mesgas/opentherm-smartthings-gateway/hardware/production/bom-lcsc.csv

Quantity | LCSC Part Number | Description | Package | Designator
2 | C1713 | 10u/16V | C_0805_2012Metric | C1,C5
1 | C1804 | 22p | C_0805_2012Metric | C2
3 | C49678 | 100n/50V / 100n | C_0805_2012Metric | C3,C6,C7
1 | C440198 | 10u/50V | C_0805_2012Metric | C4
2 | C28323 | 1u | C_0805_2012Metric | C8,C9
3 | C8598 | 1N5819W | D_SOD-123 | D1,D13,D14
4 | C7420318 | 1N4148W | D_SOD-123 | D2,D3,D4,D5
1 | C19077400 | 4V7 | D_SOD-123 | D6
1 | C22399883 | 13V | D_SOD-123 | D7
1 | C19077399 | 4V3 | D_SOD-123 | D8
1 | C22399882 | 8V2 | D_SOD-123 | D9
2 | C84256 | PWR / USER | LED_0805_2012Metric | D10,D15
1 | C2297 | RxB | LED_0805_2012Metric | D11
1 | C2296 | RxT | LED_0805_2012Metric | D12
2 | C113964 | SMAJ28CA | D_SMA | D16,D17
4 | C474892 | BOILER / THERM / 5V IN / NTC | TerminalBlock_4Ucon_1x02_P3.50mm_Horizontal | J1,J2,J5,J6
1 | C165948 | USB-C | USB_C_Receptacle_HRO_TYPE-C-31-M-12 | J3
1 | C177242 | 10uH | L_Bourns-SRN4018 | L1
4 | C7420352 | MMBT2907A | SOT-23 | Q1,Q2,Q3,Q4
2 | C8512 | MMBT2222A | SOT-23 | Q5,Q6
1 | C25824 | 240k | R_0805_2012Metric | R1
1 | C17455 | 13k | R_0805_2012Metric | R2
2 | C17630 | 330 | R_0805_2012Metric | R3,R17
1 | C17557 | 220 | R_0805_2012Metric | R4
2 | C17408 | 100 | R_0805_2012Metric | R5,R8
1 | C28636 | 560 | R_0805_2012Metric | R6
6 | C17414 | 10k | R_0805_2012Metric | R7,R12,R22,R23,R24,R25
1 | C17633 | 33k | R_0805_2012Metric | R9
2 | C17544 | 20 | R_0805_2012Metric | R10,R11
1 | C17470 | 150k | R_0805_2012Metric | R13
3 | C17513 | 1k | R_0805_2012Metric | R14,R18,R26
1 | C17673 | 4k7 | R_0805_2012Metric | R15
1 | C17798 | 680 | R_0805_2012Metric | R16
2 | C27834 | 5k1 | R_0805_2012Metric | R19,R20
1 | C110775 | 10k 0.1% | R_0805_2012Metric | R21
2 | C72443 | RESET / BOOT | SW_Push_1P1T_NO_CK_KMR2 | SW1,SW2
1 | C181783 | MT3540-F23 | SOT-23-5 | U1
2 | C109227 | LTV-817S | SMDIP-4_W9.53mm | U2,U3
1 | C2934560 | ESP32-C3-WROOM-02-N4 | ESP32-C3-WROOM-02 | U4
1 | C51118 | AP2112K-3.3 | SOT-23-5 | U5
1 | C7519 | USBLC6-2SC6 | SOT-23-6 | U6
