mesgas/opentherm-smartthings-gateway/hardware/opentherm-gateway.kicad_pcb

## KiCad design hardware/opentherm-gateway.kicad_pcb (2026-10-15)

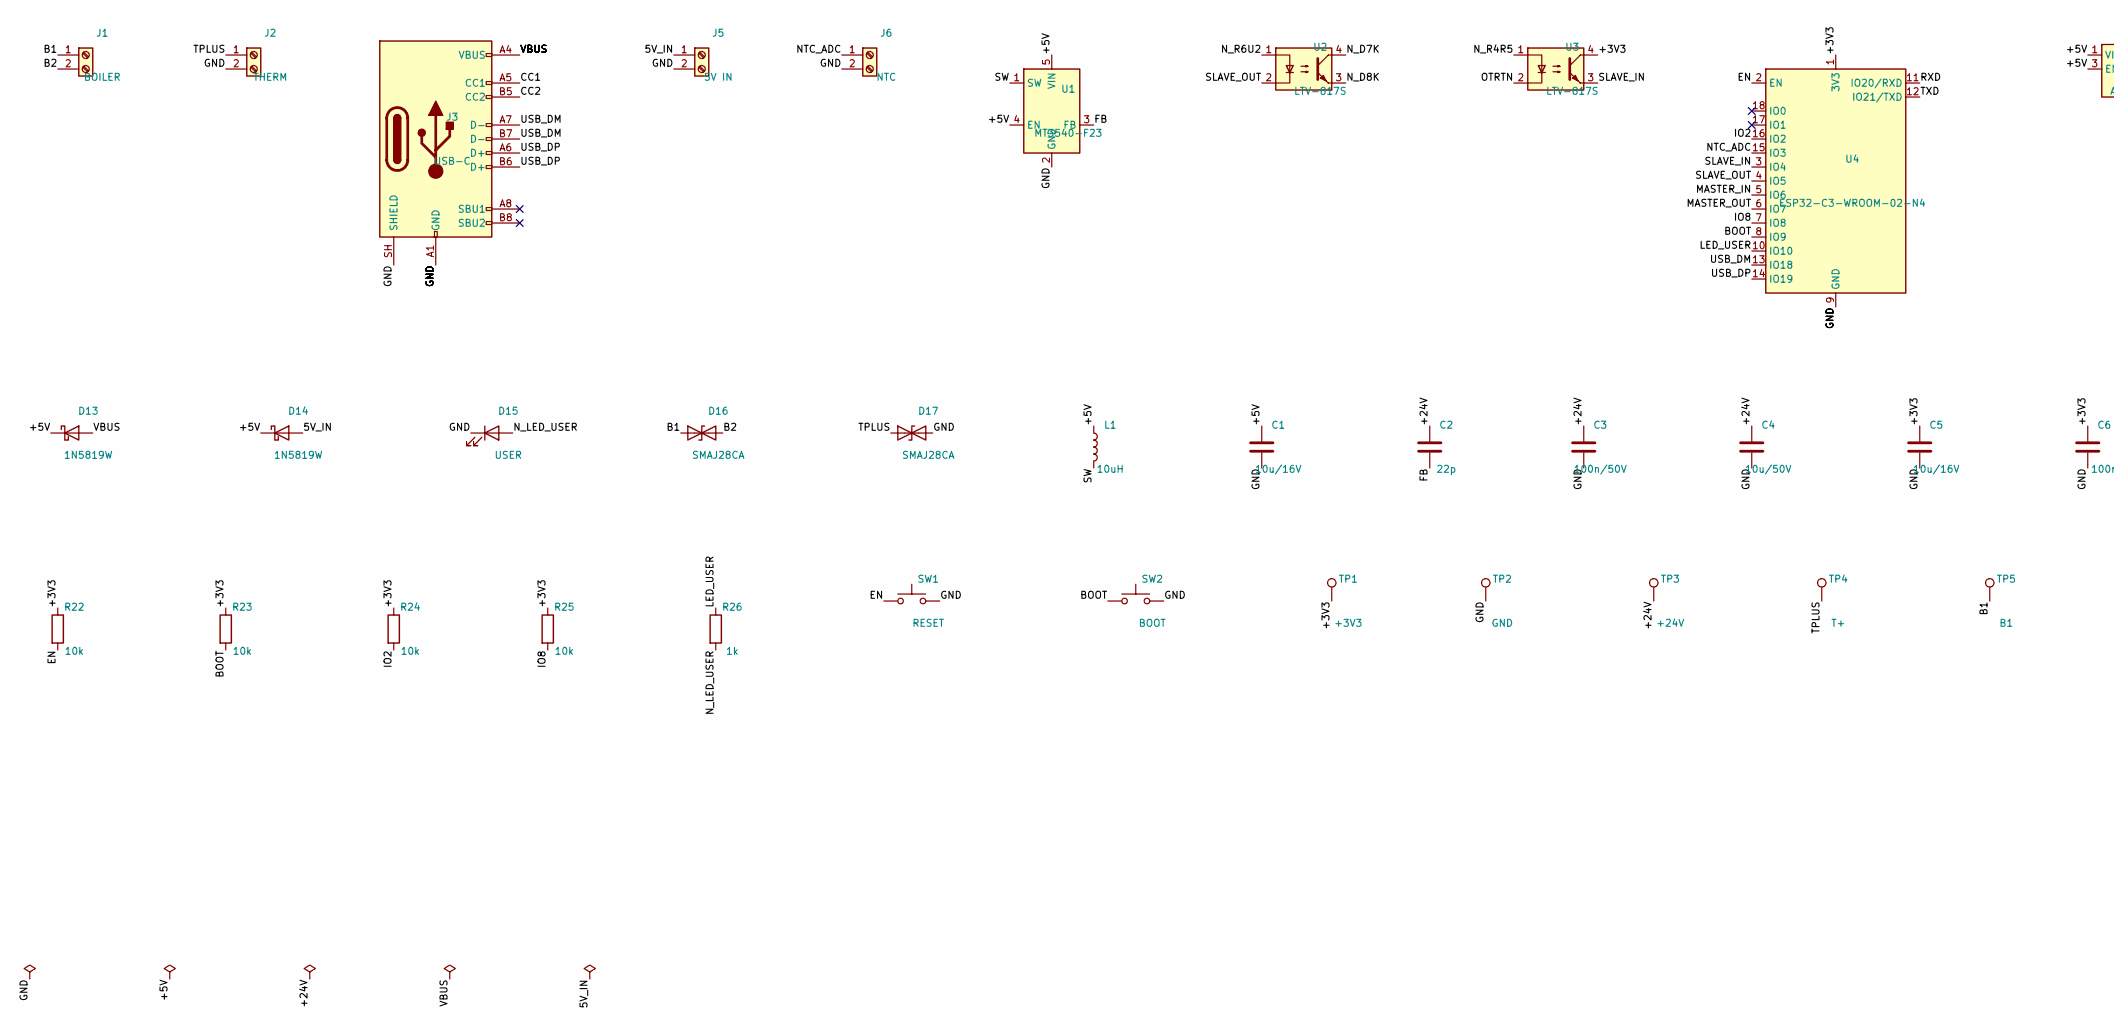
[picture p1: schematic opentherm-gateway.kicad_sch, OpenTherm gateway, part in row 1, column 1]

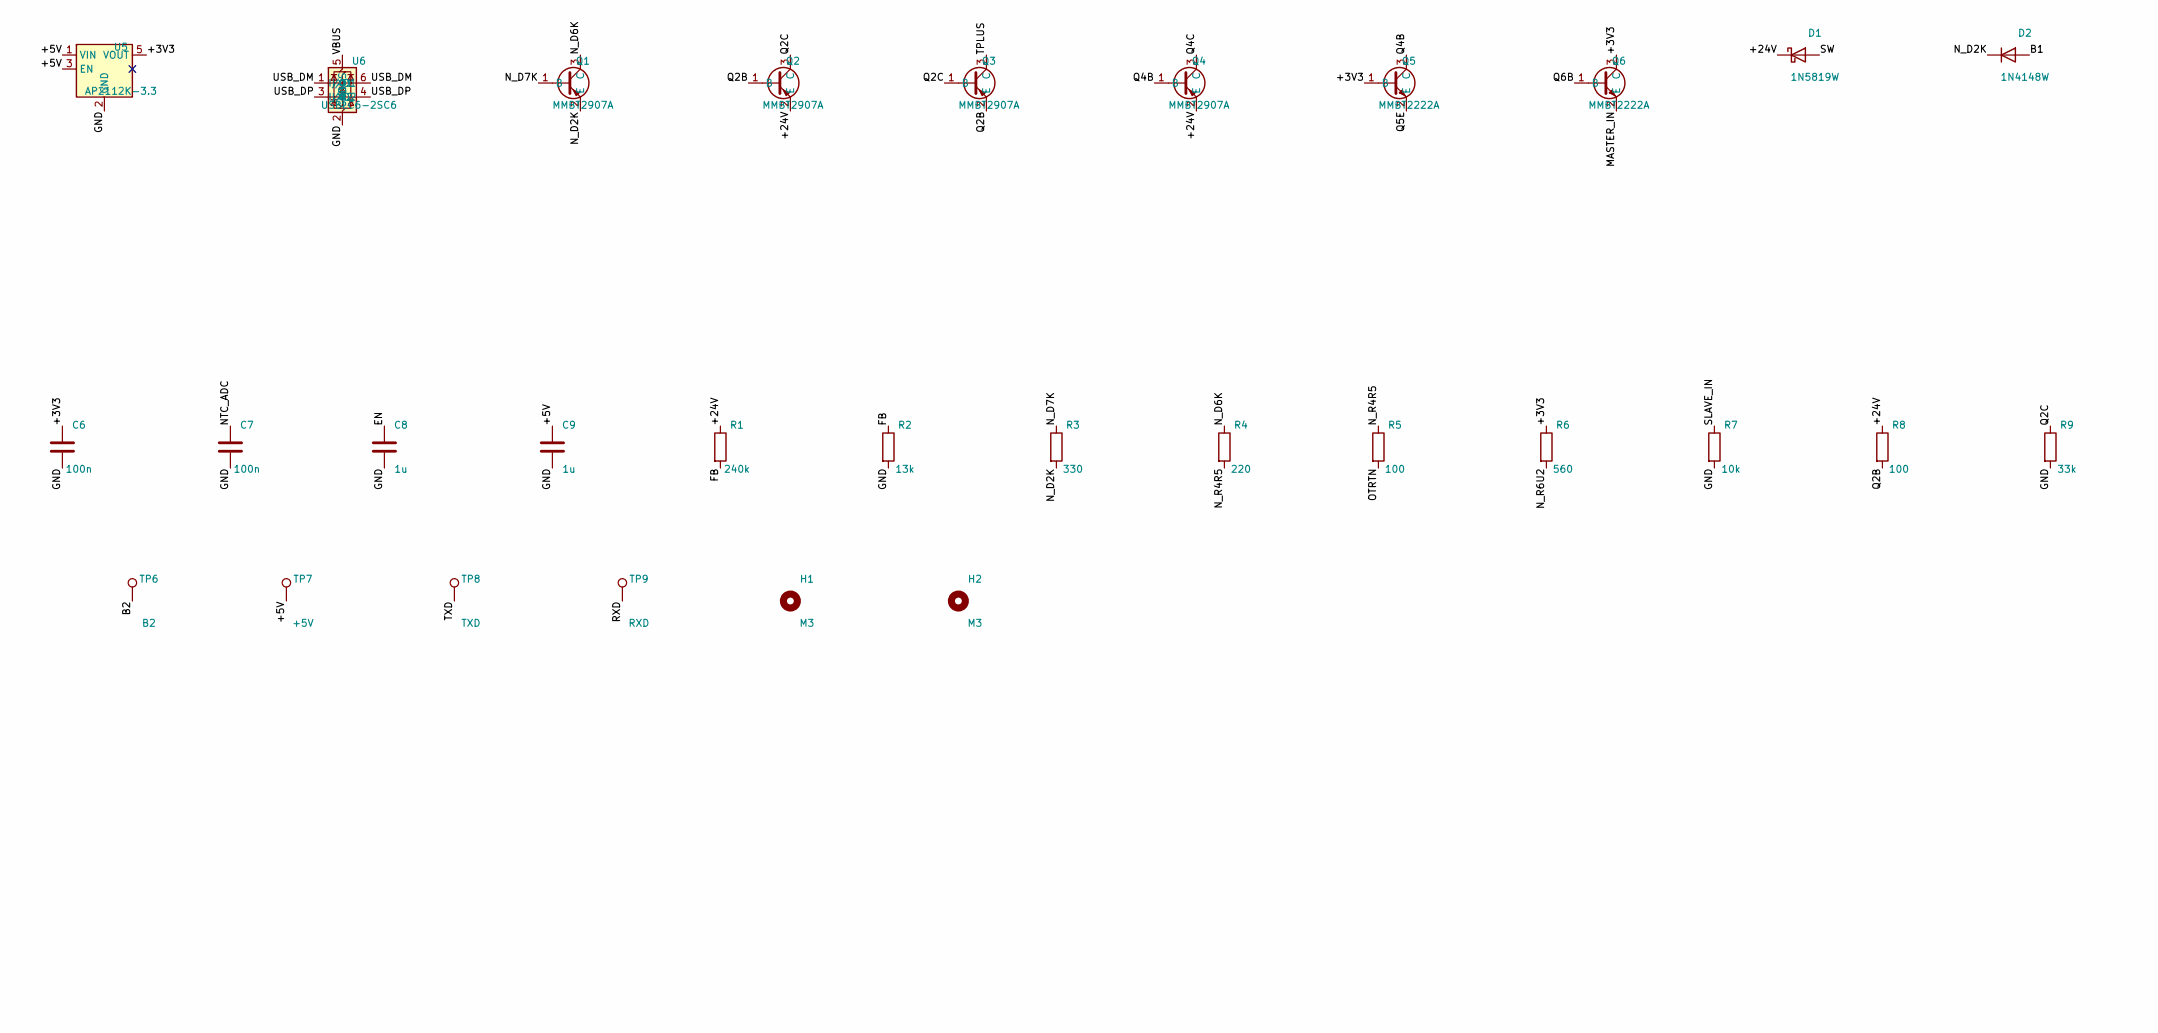
[picture p2: schematic opentherm-gateway.kicad_sch, OpenTherm gateway, part in row 1, column 2]

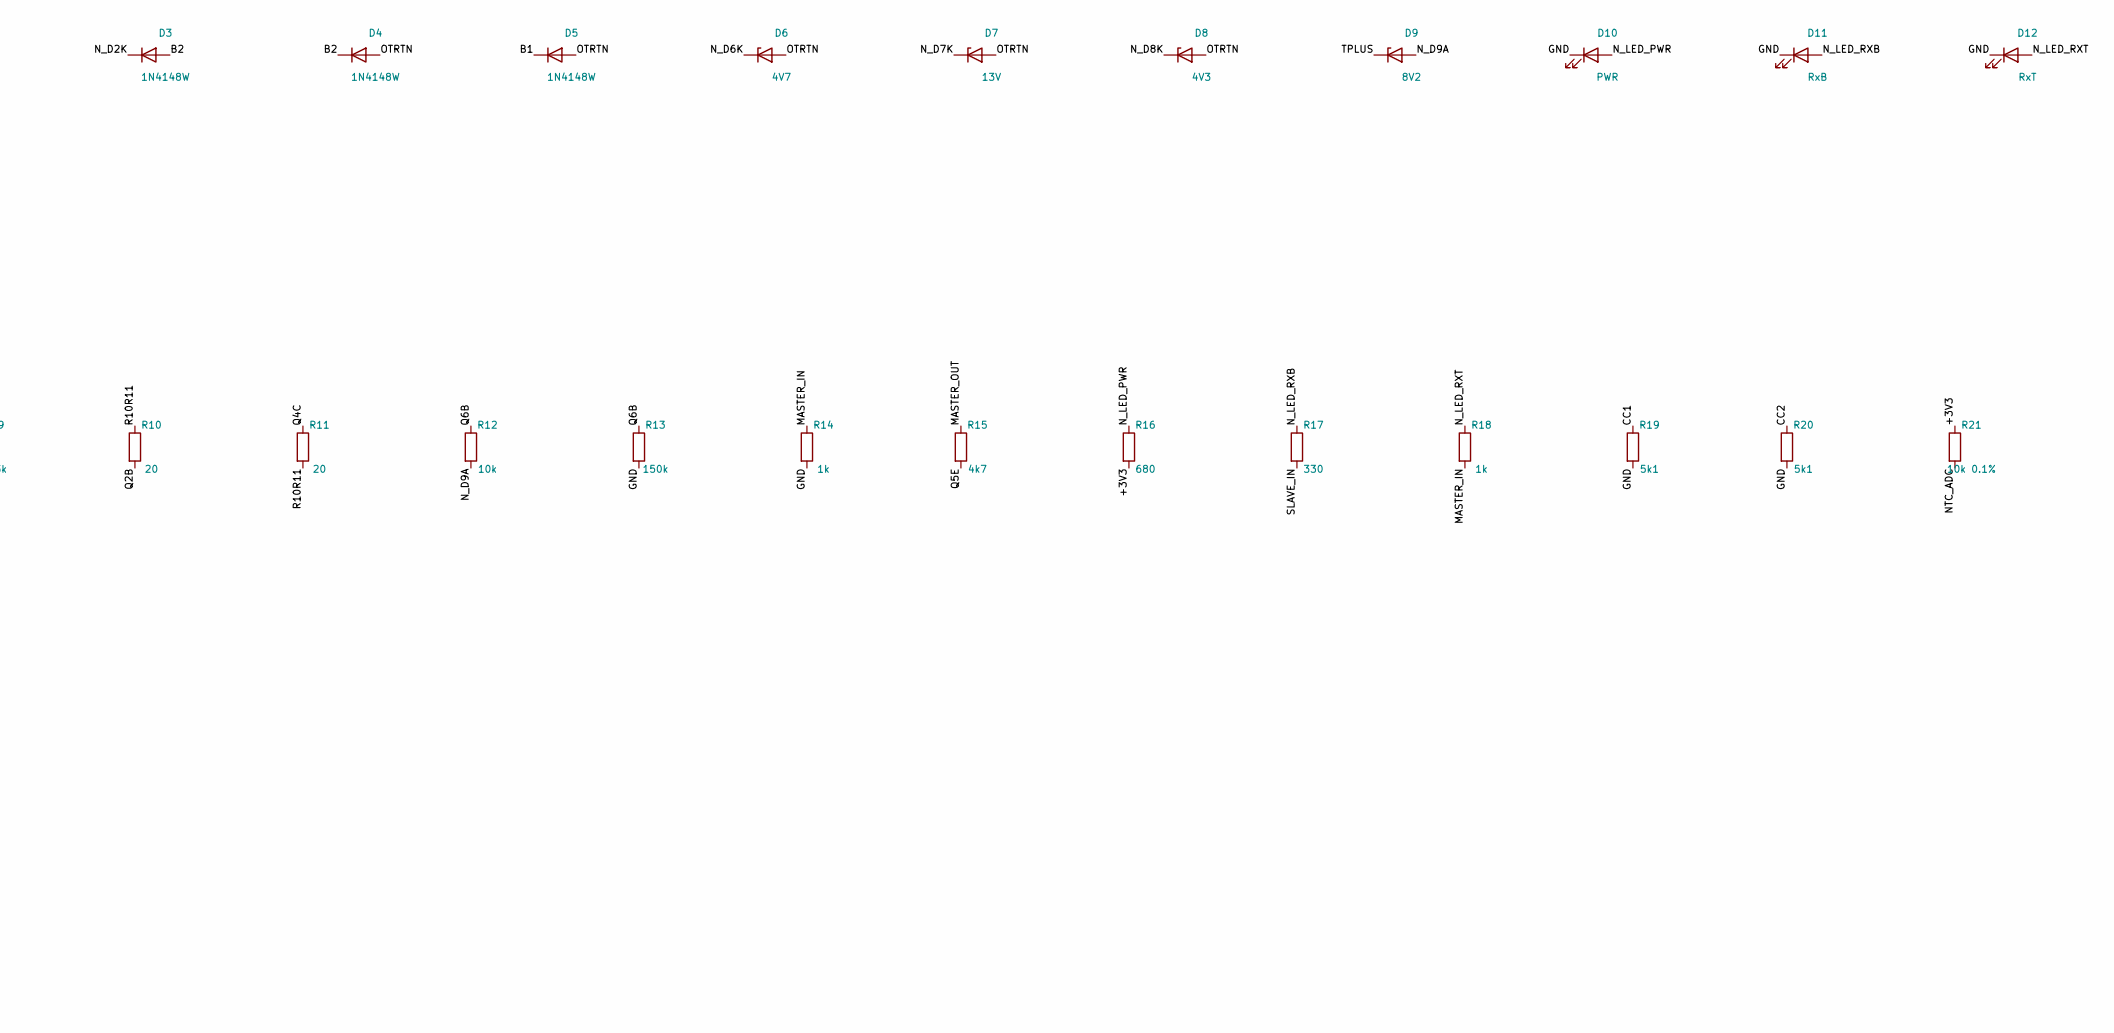
[picture p3: schematic opentherm-gateway.kicad_sch, OpenTherm gateway, part in row 1, column 3]

Parts:
C1, C5: 10u/16V; C_0805_2012Metric; LCSC C1713
C2: 22p; C_0805_2012Metric; LCSC C1804
C3: 100n/50V; C_0805_2012Metric; LCSC C49678
C4: 10u/50V; C_0805_2012Metric; LCSC C440198
C6, C7: 100n; C_0805_2012Metric; LCSC C49678
C8, C9: 1u; C_0805_2012Metric; LCSC C28323
D1, D13, D14: 1N5819W; D_SOD-123; LCSC C8598
D2, D3, D4, D5: 1N4148W; D_SOD-123; LCSC C7420318
D6: 4V7; D_SOD-123; LCSC C19077400
D7: 13V; D_SOD-123; LCSC C22399883
D8: 4V3; D_SOD-123; LCSC C19077399
D9: 8V2; D_SOD-123; LCSC C22399882
D10: PWR; LED_0805_2012Metric; LCSC C84256
D11: RxB; LED_0805_2012Metric; LCSC C2297
D12: RxT; LED_0805_2012Metric; LCSC C2296
D15: USER; LED_0805_2012Metric; LCSC C84256
D16, D17: SMAJ28CA; D_SMA; LCSC C113964
H1, H2: M3; MountingHole_3.2mm_M3
J1: BOILER; TerminalBlock_4Ucon_1x02_P3.50mm_Horizontal; LCSC C474892
J2: THERM; TerminalBlock_4Ucon_1x02_P3.50mm_Horizontal; LCSC C474892
J3: USB-C; USB_C_Receptacle_HRO_TYPE-C-31-M-12; LCSC C165948
J5: 5V IN; TerminalBlock_4Ucon_1x02_P3.50mm_Horizontal; LCSC C474892
J6: NTC; TerminalBlock_4Ucon_1x02_P3.50mm_Horizontal; LCSC C474892
L1: 10uH; L_Bourns-SRN4018; LCSC C177242
Q1, Q2, Q3, Q4: MMBT2907A; SOT-23; LCSC C7420352
Q5, Q6: MMBT2222A; SOT-23; LCSC C8512
R1: 240k; R_0805_2012Metric; LCSC C25824
R2: 13k; R_0805_2012Metric; LCSC C17455
R3, R17: 330; R_0805_2012Metric; LCSC C17630
R4: 220; R_0805_2012Metric; LCSC C17557
R5, R8: 100; R_0805_2012Metric; LCSC C17408
R6: 560; R_0805_2012Metric; LCSC C28636
R7, R12, R22, R23, R24, R25: 10k; R_0805_2012Metric; LCSC C17414
R9: 33k; R_0805_2012Metric; LCSC C17633
R10, R11: 20; R_0805_2012Metric; LCSC C17544
R13: 150k; R_0805_2012Metric; LCSC C17470
R14, R18, R26: 1k; R_0805_2012Metric; LCSC C17513
R15: 4k7; R_0805_2012Metric; LCSC C17673
R16: 680; R_0805_2012Metric; LCSC C17798
R19, R20: 5k1; R_0805_2012Metric; LCSC C27834
R21: 10k 0.1%; R_0805_2012Metric; LCSC C110775
SW1: RESET; SW_Push_1P1T_NO_CK_KMR2; LCSC C72443
SW2: BOOT; SW_Push_1P1T_NO_CK_KMR2; LCSC C72443
TP1: +3V3; TestPoint_Pad_D1.5mm
TP2: GND; TestPoint_Pad_D1.5mm
TP3: +24V; TestPoint_Pad_D1.5mm
TP4: T+; TestPoint_Pad_D1.5mm
TP5: B1; TestPoint_Pad_D1.5mm
TP6: B2; TestPoint_Pad_D1.5mm
TP7: +5V; TestPoint_Pad_D1.5mm
TP8: TXD; TestPoint_Pad_D1.5mm
TP9: RXD; TestPoint_Pad_D1.5mm
U1: MT3540-F23; SOT-23-5; LCSC C181783
U2, U3: LTV-817S; SMDIP-4_W9.53mm; LCSC C109227
U4: ESP32-C3-WROOM-02-N4; ESP32-C3-WROOM-02; LCSC C2934560
U5: AP2112K-3.3; SOT-23-5; LCSC C51118
U6: USBLC6-2SC6; SOT-23-6; LCSC C7519

Connections:
5V_IN: D14.2 (A), J5.1
+3V3: C5.1, C6.1, Q5.1 (B), Q6.3 (C), R6.1, R16.2, R21.1, R22.1, R23.1, R24.1, R25.1, TP1.1, U3.4, U4.1 (3V3), U5.5 (VOUT)
+5V: C1.1, C9.1, D13.1 (K), D14.1 (K), L1.1, TP7.1, U1.4 (EN), U1.5 (VIN), U5.1 (VIN), U5.3 (EN)
+24V: C2.1, C3.1, C4.1, D1.1 (K), Q2.2 (E), Q4.2 (E), R1.1, R8.1, TP3.1
B1: D2.2 (A), D5.1 (K), D16.1 (A1), J1.1, TP5.1
B2: D3.2 (A), D4.1 (K), D16.2 (A2), J1.2, TP6.1
BOOT: R23.2, SW2.1, U4.8 (IO9)
CC1: J3.A5 (CC1), R19.1
CC2: J3.B5 (CC2), R20.1
EN: C8.1, R22.2, SW1.1, U4.2 (EN)
FB: C2.2, R1.2, R2.1, U1.3 (FB)
GND: C1.2, C3.2, C4.2, C5.2, C6.2, C7.2, C8.2, C9.2, D10.1 (K), D11.1 (K), D12.1 (K), D15.1 (K), D17.2 (A2), J2.2, J3.A1 (GND), J3.A12 (GND), J3.B1 (GND), J3.B12 (GND), J3.SH (SHIELD), J5.2, J6.2, R2.2, R7.2, R9.2, R13.2, R14.2, R19.2, R20.2, SW1.2, SW2.2, TP2.1, U1.2 (GND), U4.9 (GND), U4.19 (GND), U5.2 (GND), U6.2 (GND)
IO2: R24.2, U4.16 (IO2)
IO8: R25.2, U4.7 (IO8)
LED_USER: R26.1, U4.10 (IO10)
MASTER_IN: Q6.2 (E), R14.1, R18.2, U4.5 (IO6)
MASTER_OUT: R15.1, U4.6 (IO7)
NTC_ADC: C7.1, J6.1, R21.2, U4.15 (IO3)
N_D2K: D2.1 (K), D3.1 (K), Q1.2 (E), R3.2
N_D6K: D6.1 (K), Q1.3 (C), R4.1
N_D7K: D7.1 (K), Q1.1 (B), R3.1, U2.4
N_D8K: D8.1 (K), U2.3
N_D9A: D9.2 (A), R12.2
N_LED_PWR: D10.2 (A), R16.1
N_LED_RXB: D11.2 (A), R17.1
N_LED_RXT: D12.2 (A), R18.1
N_LED_USER: D15.2 (A), R26.2
N_R4R5: R4.2, R5.1, U3.1
N_R6U2: R6.2, U2.1
OTRTN: D4.2 (A), D5.2 (A), D6.2 (A), D7.2 (A), D8.2 (A), R5.2, U3.2
Q2B: Q2.1 (B), Q3.2 (E), R8.2, R10.2
Q2C: Q2.3 (C), Q3.1 (B), R9.1
Q4B: Q4.1 (B), Q5.3 (C)
Q4C: Q4.3 (C), R11.1
Q5E: Q5.2 (E), R15.2
Q6B: Q6.1 (B), R12.1, R13.1
R10R11: R10.1, R11.2
RXD: TP9.1, U4.11 (IO20/RXD)
SLAVE_IN: R7.1, R17.2, U3.3, U4.3 (IO4)
SLAVE_OUT: U2.2, U4.4 (IO5)
SW: D1.2 (A), L1.2, U1.1 (SW)
TPLUS: D9.1 (K), D17.1 (A1), J2.1, Q3.3 (C), TP4.1
TXD: TP8.1, U4.12 (IO21/TXD)
USB_DM: J3.A7 (D-), J3.B7 (D-), U4.13 (IO18), U6.1 (I/O1), U6.6 (I/O1)
USB_DP: J3.A6 (D+), J3.B6 (D+), U4.14 (IO19), U6.3 (I/O2), U6.4 (I/O2)
VBUS: D13.2 (A), J3.A4 (VBUS), J3.A9 (VBUS), J3.B4 (VBUS), J3.B9 (VBUS), U6.5 (VBUS)

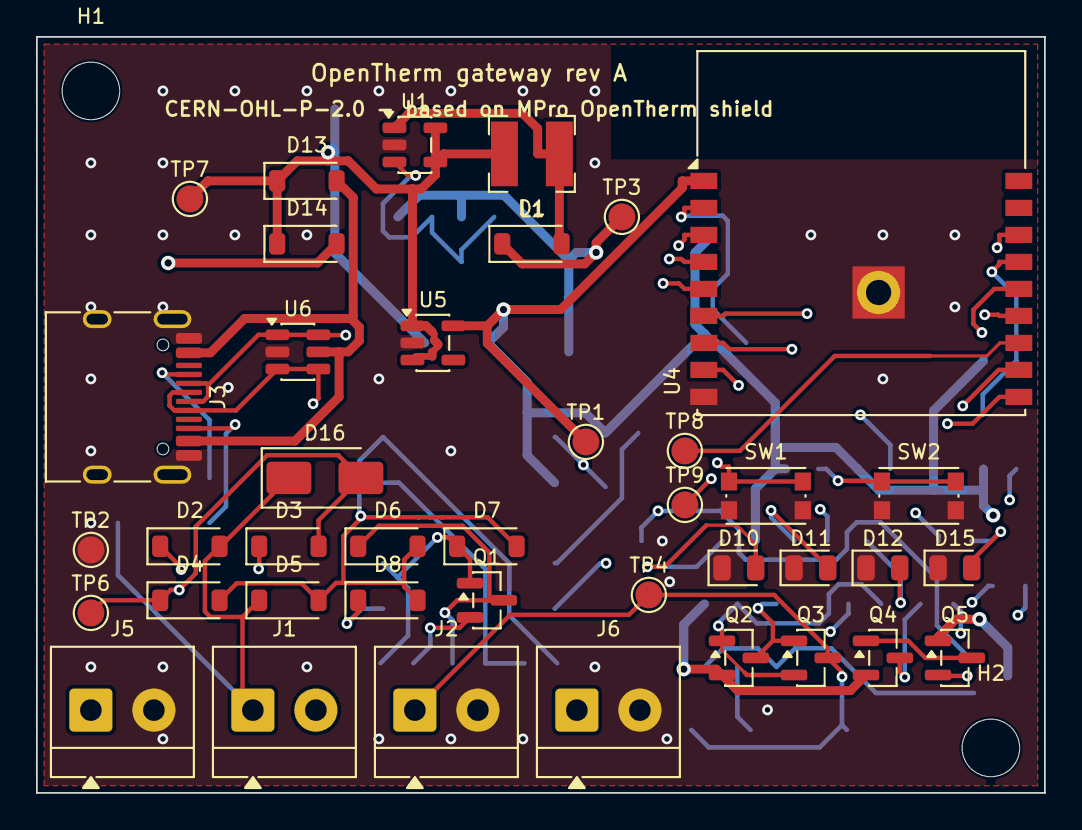
[picture p4: board opentherm-gateway.kicad_pcb from above]

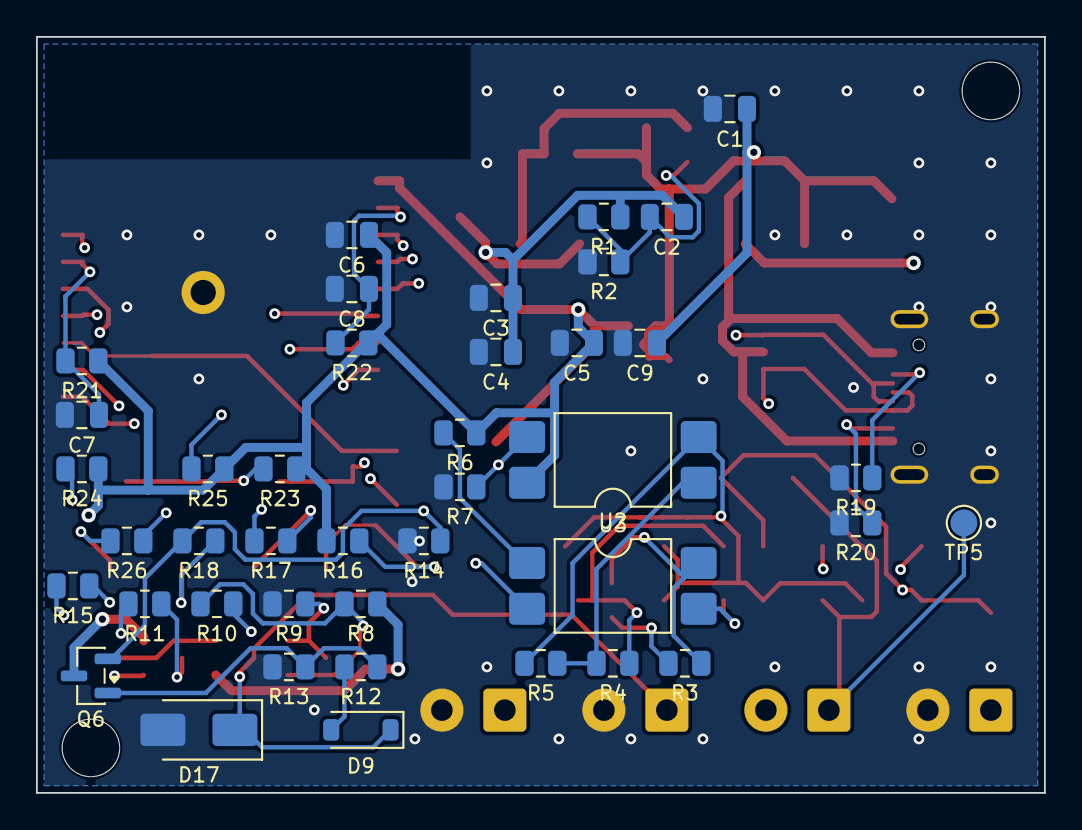
[picture p5: board opentherm-gateway.kicad_pcb from below]

Board: 4 copper layers, 56.0 x 42.0 mm, 83 parts (41 on the bottom side), 46 nets.
