mesgas/opentherm-smartthings-gateway/hardware/gen/placement.py

"""Placement table: ref -> (x, y, rotation_deg, side). Board origin top-left, mm.

Compact 4-layer board, parts on both sides:
  top    USB-C (left edge), ESP32-C3-WROOM-02 (antenna to the top edge), 4 screw terminals along
         the bottom edge, buttons, LEDs, boost converter, boiler-side bridge/zeners
  bottom optocouplers (isolation barrier), thermostat-side transistors, small passives
"""
BOARD_W = 56.0
BOARD_H = 42.0

PLACE = {
    # --- connectors / mechanical ---------------------------------------------------
    "J3": (4.4, 20.0, 270, "F"),
    "U4": (45.8, 14.0, 0, "F"),
    "J5": (3.0, 37.4, 0, "F"),
    "J1": (12.0, 37.4, 0, "F"),
    "J2": (21.0, 37.4, 0, "F"),
    "J6": (30.0, 37.4, 0, "F"),
    "H1": (3.0, 3.0, 0, "F"),
    "H2": (53, 39.5, 0, "F"),
    "H3": (53.0, 3.0, 0, "B"),     # placeholder, removed below
    "H4": (3.0, 39.0, 0, "B"),
    # --- USB / supply ---------------------------------------------------------------
    "U6": (14.5, 17.5, 0, "F"),
    "D13": (15.0, 8.0, 0, "F"),
    "D14": (15.0, 11.5, 0, "F"),
    "R19": (10.5, 24.5, 0, "B"),
    "R20": (10.5, 27.0, 0, "B"),
    "U5": (22.0, 17.0, 0, "F"),
    "C5": (26, 17, 0, "B"),
    "C9": (22.5, 17, 0, "B"),
    # --- boost converter ------------------------------------------------------------
    "U1": (21.0, 6.0, 0, "F"),
    "L1": (27.5, 6.5, 0, "F"),
    "D1": (27.5, 11.5, 0, "F"),
    "C1": (17.5, 4.0, 0, "B"),
    "C2": (21.0, 10.0, 0, "B"),
    "R1": (24.5, 10.0, 0, "B"),
    "R2": (24.5, 12.5, 0, "B"),
    "C3": (30.5, 14.5, 0, "B"),
    "C4": (30.5, 17.5, 0, "B"),
    # --- MCU --------------------------------------------------------------------------
    "C6": (38.5, 11.0, 0, "B"),
    "C8": (38.5, 14.0, 0, "B"),
    "SW1": (40.5, 25.5, 0, "F"),
    "SW2": (49.0, 25.5, 0, "F"),
    "R22": (38.5, 17.0, 0, "B"),
    "R23": (42.5, 24.0, 0, "B"),
    "R25": (46.5, 24.0, 0, "B"),
    "R24": (53.5, 24.0, 0, "B"),
    "R21": (53.5, 18.0, 0, "B"),
    "C7": (53.5, 21.0, 0, "B"),
    "R26": (51.0, 28.0, 0, "B"),
    "D15": (51, 29.5, 0, "F"),
    "D10": (39, 29.5, 0, "F"),
    "D11": (43, 29.5, 0, "F"),
    "D12": (47, 29.5, 0, "F"),
    "R16": (39, 28, 0, "B"),
    "R17": (43, 28, 0, "B"),
    "R18": (47, 28, 0, "B"),
    # --- boiler side (OTRTN) ------------------------------------------------------------
    "D2": (8.5, 28.3, 0, "F"),
    "D3": (14, 28.3, 0, "F"),
    "D4": (8.5, 31.3, 0, "F"),
    "D5": (14, 31.3, 0, "F"),
    "D6": (19.5, 28.3, 0, "F"),
    "D7": (25, 28.3, 0, "F"),
    "D8": (19.5, 31.3, 0, "F"),
    "Q1": (25, 31.3, 0, "F"),
    "R3": (20, 34.8, 0, "B"),
    "R4": (24, 34.8, 0, "B"),
    "R5": (28, 34.8, 0, "B"),
    "D16": (16, 24.5, 0, "F"),
    "TP5": (4.5, 27, 0, "B"),
    "TP6": (3, 32, 0, "F"),
    # --- optocouplers -----------------------------------------------------------------------
    "U3": (24, 23.5, 0, "B"),
    "U2": (24, 30.5, 180, "B"),
    "R6": (32.5, 22, 0, "B"),
    "R7": (32.5, 25, 0, "B"),
    # --- thermostat side -------------------------------------------------------------------
    "D9": (38, 38.5, 0, "B"),
    "D17": (47, 38.5, 0, "B"),
    "Q2": (39, 34.5, 0, "F"),
    "Q3": (43, 34.5, 0, "F"),
    "Q4": (47, 34.5, 0, "F"),
    "Q5": (51, 34.5, 0, "F"),
    "Q6": (53, 35.5, 0, "B"),
    "R8": (38, 31.5, 0, "B"),
    "R9": (42, 31.5, 0, "B"),
    "R10": (46, 31.5, 0, "B"),
    "R11": (50, 31.5, 0, "B"),
    "R12": (38, 35, 0, "B"),
    "R13": (42, 35, 0, "B"),
    "R14": (34.5, 28.0, 0, "B"),
    "R15": (54, 30.5, 0, "B"),
    # --- test points -----------------------------------------------------------------------
    "TP1": (30.5, 22.5, 0, "F"),
    "TP2": (3, 28.5, 0, "F"),
    "TP3": (32.5, 10, 0, "F"),
    "TP4": (34, 31, 0, "F"),
    "TP7": (8.5, 9, 0, "F"),
    "TP8": (36.0, 23.0, 0, "F"),
    "TP9": (36.0, 26.0, 0, "F"),
}
# only two M3 holes (diagonal): wall mounting
del PLACE["H3"], PLACE["H4"]
