mesgas/opentherm-smartthings-gateway/(commit log)

2026-10-01 Primo commit: gateway OpenTherm per SmartThings
    Firmware ESP32-C3 (inoltro trasparente OpenTherm, API HTTP/JSON, regolazione
    ambiente e mandata, sonda esterna NTC opzionale) e driver SmartThings Edge
    con capability personalizzate.
2026-10-01 Translate the whole repository to English
    README, code comments, serial/log messages, API error messages, driver
    strings and preference texts are now in English. The SmartThings UI labels
    (component names and capability presentations) stay Italian and are
    documented as such in the README.
    [config.h, main.cpp, opentherm-gateway.yml, secrets.example.h]
2026-10-01 Let the flow ceiling follow the real flow temperature when far below target
    When the room is more than CTRL_BOOST_ERR below the target, the flow
    ceiling now rises to the measured flow temperature plus CTRL_FIRE_MARGIN,
    so the requested flow is above the actual one and the burner fires
    instead of waiting for the 30-minute boost.
    [config.h, main.cpp]
2026-10-01 Show the requested flow temperature in SmartThings
    Add a "Requested flow" component (temperatureMeasurement) fed by the flow
    setpoint actually sent to the boiler, and keep that value in sync when the
    gateway writes the setpoint itself.
2026-10-03 Add a statistics page with 24 h charts
    A 24 h ring buffer (one bucket per minute, ~23 KB of RAM) feeds a statistics
    page served by the ESP: flame, heating and hot water time, burner starts,
    average modulation, condensing share and temperature/modulation charts.
    Heavy requests are limited to one every 2 seconds so the OpenTherm relay
    is not disturbed. Lifetime burner hours and starts are saved to flash.
    [main.cpp]
2026-10-03 Add a 30-day history, persisted to flash
    A second tier keeps 30 days in 30-minute buckets (about 35 KB of RAM). It is
    saved to LittleFS every hour and before an OTA update and restored at boot.
    The statistics page gets a 24 h / 30 d toggle, the stats and history endpoints
    accept ?range=30d, and average modulation is now weighted by flame time.
    The page no longer counts against the heavy-request rate limit.
    [main.cpp]
2026-10-15 Hardware: single-board gateway PCB (ESP32-C3-WROOM-02 + OpenTherm master/slave), firmware profile
    4-layer 56x42 mm board, KiCad 10 project generated from a single netlist (schematic, board,
    Gerbers, BOM). OpenTherm front end derived from the MPro OpenTherm shield (CERN-OHL-P-2.0).
    Firmware: gateway_pcb environment with the board pin map.
2026-10-15 hardware: complete BOM with LCSC part numbers (JLCPCB format too), fix ESP32 module code, R17 330R for the green LED
2026-10-15 hardware: plated hole in the ESP32 module GND pad for soldering from the bottom side
2026-10-15 hardware: JLCPCB BOM with one row per part number (no duplicates)
2026-10-15 hardware: BOM for the LCSC BOM tool (quantity column, one row per part number)
