mesgas/opentherm-smartthings-gateway/(notices)

Notices in the files:
hardware/opentherm-gateway.kicad_pcb:
CERN-OHL-P-2.0 - based on MPro OpenTherm shield
